Ankan0503/Aether/docs/aether-hierarchy.png

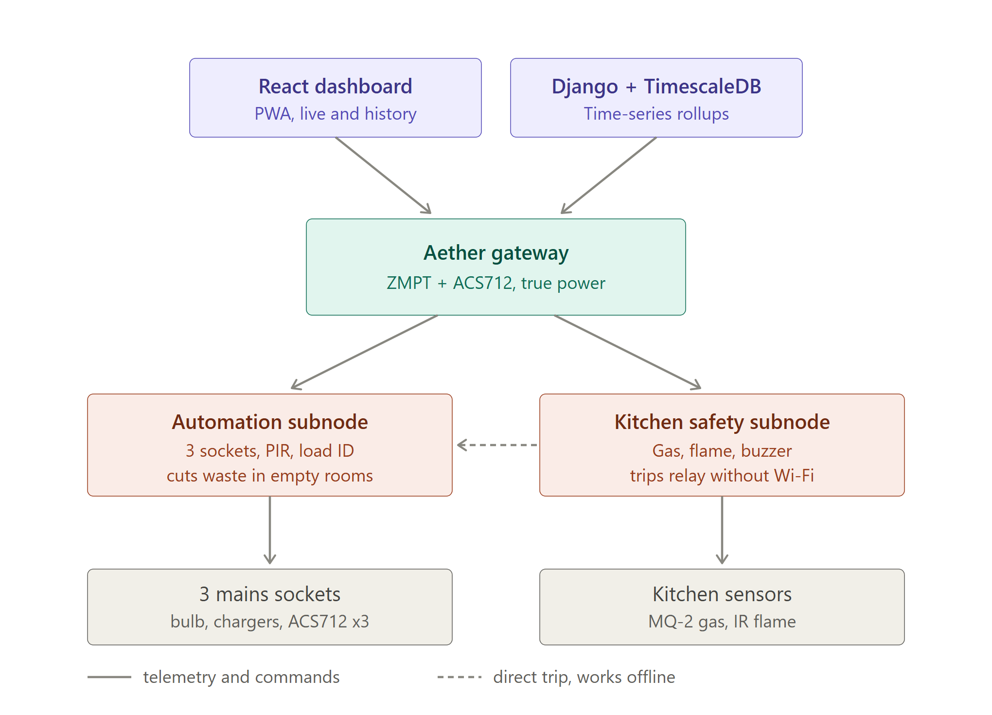
docs/aether-hierarchy.png
