Ankan0503/Aether/docs/waveforms/01-filament-bulb-100w.png

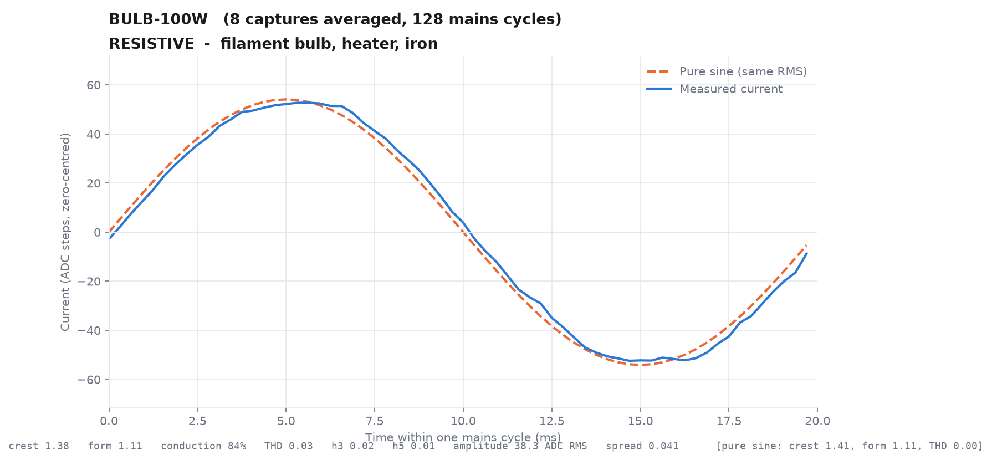
docs/waveforms/01-filament-bulb-100w.png
