Ankan0503/Aether/docs/waveforms/02-laptop-charger-barrel-no-pfc.png

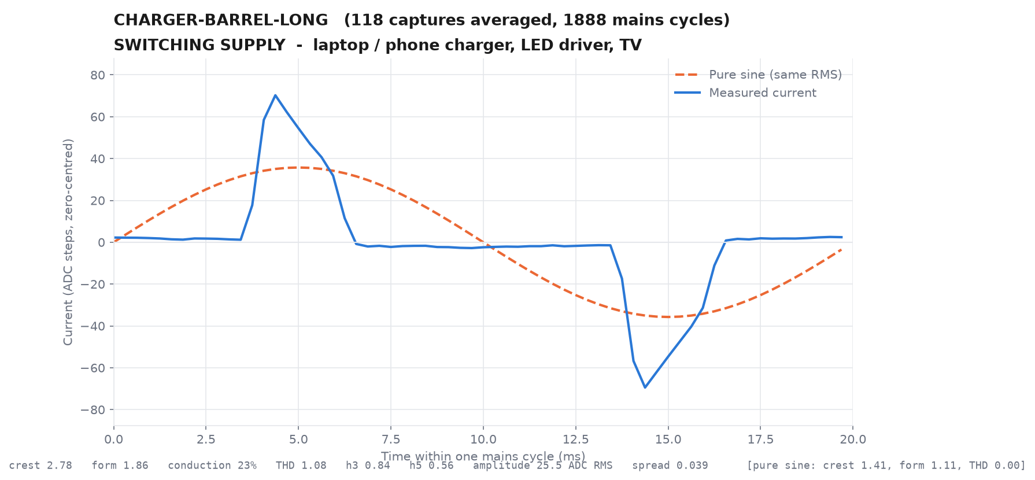
docs/waveforms/02-laptop-charger-barrel-no-pfc.png
