Ankan0503/Aether/docs/waveforms/03-usbc-charger-100w-partial-pfc.png

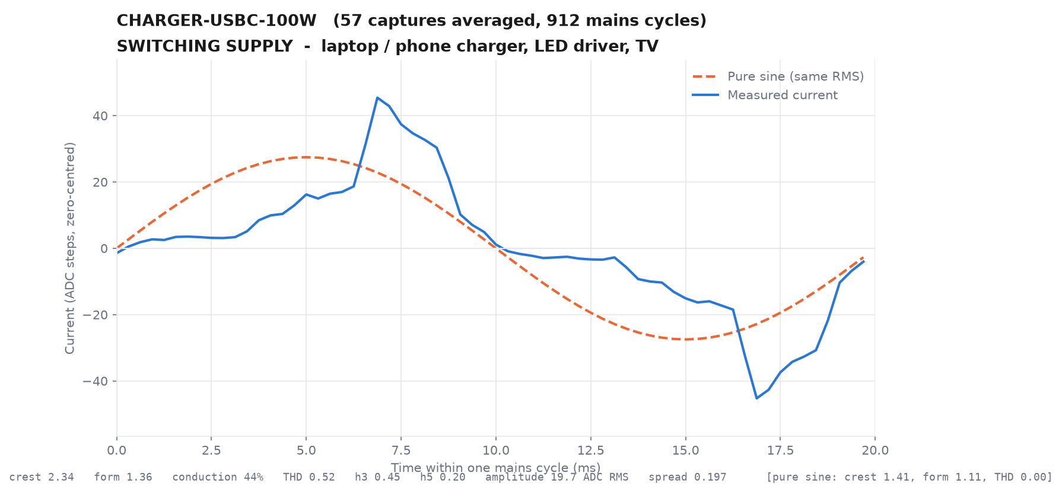
docs/waveforms/03-usbc-charger-100w-partial-pfc.png
