Ankan0503/Aether/docs/waveforms/04-all-three-compared.png

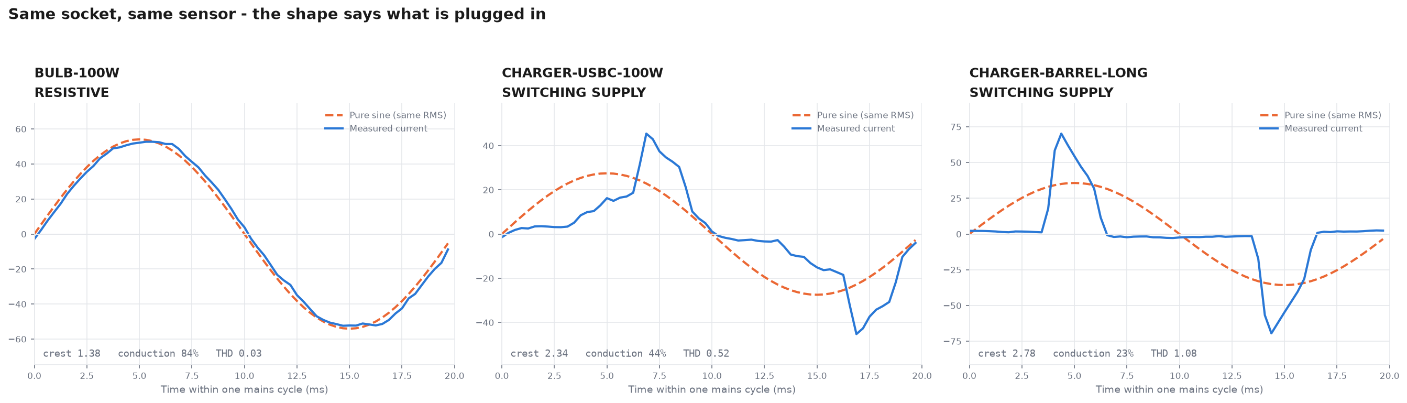
docs/waveforms/04-all-three-compared.png
