Ankan0503/Aether/docs/waveforms/05-noise-floor-empty-socket.png

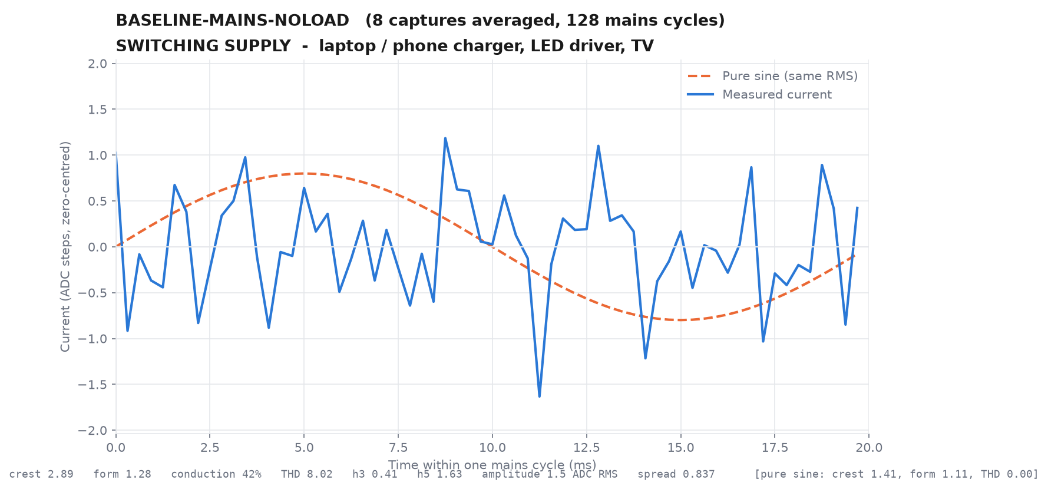
docs/waveforms/05-noise-floor-empty-socket.png
