Ankan0503/Aether/docs/waveforms/06-simulated-reference.png

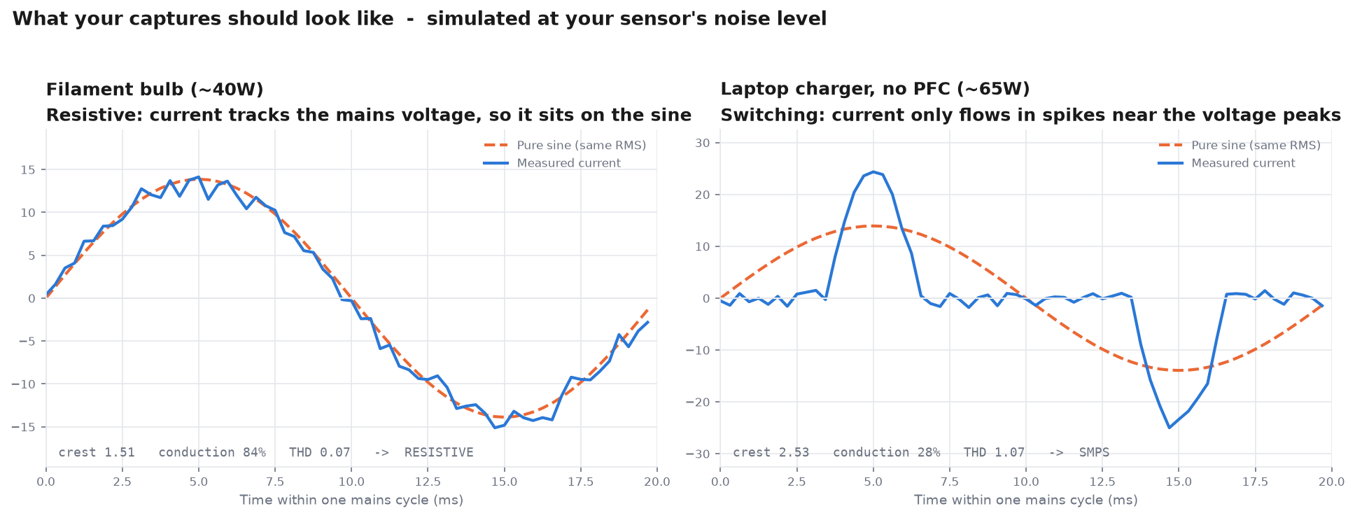
docs/waveforms/06-simulated-reference.png
