Ankan0503/Aether/(commit log)

2026-09-25 Add ESP32 waveform capture and load signature extraction
    Capture one mains cycle of current and reduce it to shape features that do not
    depend on amplitude: crest factor, form factor, conduction angle, THD and the
    odd harmonics.
    Sampling is paced with micros() rather than delayMicroseconds() so the time
    analogRead() itself takes cannot stretch the interval - an uneven sample rate
    smears the harmonics.
    Sixteen consecutive cycles are coherently averaged, anchored to a rising zero
    crossing. Mains-synchronous signal adds linearly while noise adds as sqrt(N),
    which is what makes a small load legible on a 30A ACS712 that resolves only
    about 2.8W per ADC step.
    [Waveform.h]
2026-09-25 Add standalone bench sketch with relay control
    Drives the 4-channel relay board and the ACS712 inputs directly over serial,
    with no Wi-Fi or mesh, so the measurement chain can be proven before any of the
    networking exists. Stores one device profile in NVS so it survives a reboot.
    Relay pins are driven HIGH before pinMode() sets them as outputs. An ESP32 GPIO
    is an input on reset, so an active-LOW relay board would otherwise see a
    floating line and click ON during boot - a real switch-on of a mains socket on
    every reset.
    [Waveform.h, WaveformBench.ino]
2026-09-25 Add shape-based load classifier
    Decode the firmware's base64 cycle, extract shape features and label the load
    as resistive, switching supply or mixed.
    Every feature is computed after normalising by the waveform's own RMS, so the
    classifier is unaffected by ACS712 zero-offset drift, a mis-set sensitivity
    constant or a fixed-voltage power assumption. Shape survives what magnitude
    does not.
    The rule is deliberately small and explainable, and doubles as the fallback and
    the sanity check behind any trained model.
    [load_signature.py]
2026-09-25 Add hardware-free validation of the feature maths
    Synthesise a filament bulb and a non-PFC supply at this sensor's noise level
    and assert the features land where theory says they should.
    The single-cycle case is asserted to FAIL classification while the 16-cycle
    average passes. That contrast is the justification for the coherent averaging,
    so if it ever starts passing the noise model has gone soft.
    [preview_graph.py, selftest.py]
2026-09-25 Add serial capture and relay verification tools
    capture_once.py collects several captures, aligns them by cross-correlation
    and averages. Alignment matters because the zero-crossing anchor is crisp for a
    sine but ambiguous for a supply that sits at zero most of the cycle - averaging
    misaligned captures flattens the spikes and under-reads crest factor badly.
    It reports amplitude spread and shape spread separately, so a loose plug
    (amplitude moves, shape does not) is not mistaken for an unstable reading. The
    relay is opened in a finally block so a finished, failed or interrupted capture
    never leaves a mains socket live.
    relay_test.py confirms a channel physically opens, using the current sen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
    [capture_once.py, relay_test.py]
2026-09-25 Add live oscilloscope and multi-device comparison plots
    Both draw the measured current against a pure sine of the same RMS. Equal area
    under the curve means any visible difference is shape alone, which is exactly
    what the classifier decides on - so the plot shows the reasoning rather than
    just the result.
2026-09-25 Add training pipeline for the load classifier
    Collect labelled waveforms over serial, then fit a shallow decision tree on the
    shape features.
    Shallow on purpose: the learned rules can be printed and read aloud, and with
    features this separable the extra capacity would buy accuracy that cannot be
    demonstrated. Training also prints the hand-written rule's accuracy beside the
    model's, so a model that does not earn its place is visible immediately.
2026-09-25 Add appliance identification with measured reference waveforms
    Match a live capture against known devices by point-by-point shape distance
    after normalisation and phase alignment, rather than by thresholds - the two
    chargers are far closer to each other than either is to the bulb, and a
    threshold that splits resistive from switching cannot separate them.
    Reference captures measured on the rig: a 100W bulb at crest 1.38 against the
    theoretical 1.414, a non-PFC barrel charger at 2.78 with conduction collapsing
    from 84% to 23%, and a partially-corrected 100W USB-C brick between them at
    2.34.
    [captures.csv]
2026-09-25 Add three.js digital twin view
    Interactive 3D model of the home, showing per-room load and the state of each
    switched socket in place rather than as a list.
2026-09-25 Add safety, control, automation and event views
    Hazard hub, the full-screen safety alert overlay with its audio alarm, manual
    relay control, automation rules, settings and the event history feed.
2026-09-25 Add container and nginx deployment config for the frontend
    Multi-stage build serving the built assets through nginx, with the API origin
    templated at runtime.
2026-09-25 Document the load signature approach and measured results
    Covers why shape beats magnitude on this hardware, the measured reference
    values, the wiring and the blind test in which appliances swapped between
    sockets were each identified correctly.
2026-09-25 Document the pin map for all three node types
    Gateway, automation subnode and kitchen safety node, with the ESP32 rules each
    map obeys - ADC1 only for analog since ADC2 dies once Wi-Fi is up, the
    input-only pins, the strapping pins, and driving an active-LOW relay high
    before pinMode so it does not click on at boot.
    Records why socket 3 runs through the relay board's channel 4, and the ZMPT
    trim-pot procedure: set too high it clips flat and corrupts both RMS voltage
    and power factor while still producing plausible numbers.
2026-09-25 Add gateway metering with true power and power factor
    The gateway is the only node measuring voltage and current on the same circuit
    at the same moment, so it is the only place active power can be computed rather
    than guessed.
    Vrms x Irms is apparent power. mean(v*i) is active power, which is what the
    meter bills. Their ratio is the power factor, and on a reactive load the two
    differ by a factor of two - so every rupee figure in the project should come
    from here rather than from a subnode assuming a voltage.
    The DC bias is measured per window instead of assumed to be half rail. Both
    modules centre their output through a trim pot and a divider, neither lands
    exactly at Vcc/2, and both drift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
    [AetherGateway.ino, Metering.h]
2026-09-25 Add metering validation against analytically known loads
    Checks the gateway arithmetic with no hardware: a resistive load must give
    power factor 1.0, a load lagging 60 degrees must give exactly 0.5, a distorted
    but in-phase supply must fall below 1 from harmonics alone, and an off-centre
    bias must change nothing.
    It caught a real fault. MT_PHASE_SHIFT interpolates between the previous and
    current voltage sample, so 1.0 means no correction - but it was set to 0.30,
    which is most of a sample of lag. At 32 samples per cycle that is 11.25
    degrees, and cos(60 - 11.25) = 0.659 matched the wrong output exactly. On
    hardware it would have quietly overstated power on every reactive load.
    [metering_selftest.py]
2026-09-25 Add subnode occupancy cutoff and per-socket load identification
    Three sockets, each identified by current waveform shape, opened automatically
    when something is drawing and the room has been empty.
    The rule is built around what the sensor can actually see. A 30A ACS712 has a
    measured noise floor near 1.5 ADC RMS steps and true standby draw is about 0.5,
    so standby is invisible and a rule waiting to detect it would never fire. What
    is visible is a load still drawing with nobody present - a lamp left on, a
    charger still pulling - and that is real waste worth cutting.
    Savings are reported in ADC-step-seconds rather than watts on purpose: the
    subnode has no voltage reference, and converting wo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
    [AetherSubNode.ino, Occupancy.h, Waveform.h]
2026-09-25 Add system hierarchy diagram
    Four tiers from dashboard down to sensors, showing the gateway as the only
    point measuring voltage and current together, and the direct ESP-NOW link
    between the kitchen and automation subnodes that keeps gas and fire cutoff
    working with Wi-Fi down.
2026-09-25 Add device registry, pairing and layout
    Device discovery, MQTT pairing commands, appliance toggling and the room and
    door models the occupancy logic will need.
    Fixes a missing 'from django.db.models import Q' import that made every device
    deletion fail with a 500 and leave the device, its telemetry and its load
    signatures behind - it was used in five places and imported in none.
2026-09-25 Add telemetry ingestion and the MQTT listener
    Subscribes to aether/#, parses node payloads and records readings.
    Two fixes on top of the imported code. The node's declared role is now honoured
    instead of being inferred from whether c1-c4 appear in the payload: the gateway
    carries no per-socket currents, so it was being registered as a plain sensor -
    the one device that can actually measure power factor, mislabelled.
    And a socket prediction failure no longer aborts the ingest. It reads back
    recent history, so it raises whenever there is none, and the exception was
    taking the whole payload down with it.
2026-09-25 Store telemetry on change rather than on every sample
    The gateway publishes every 2 seconds and a relay node writes one row per
    socket plus a combined one - about 172,800 rows a day, near 50 MB, which
    exhausts a small managed database in a fortnight. Almost every one of those
    rows repeats the previous value.
    Deadband plus heartbeat: keep a sample when something changed, or when it has
    been 60 seconds since the last one. A steady load drops from 43,200 rows a day
    per stream to 1,440 while every transition is still recorded at full fidelity.
    Safety is exempt. A change in status or flame, or a gas reading crossing its
    threshold, is always stored immediately - a deduplication rule must never b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
2026-09-25 Separate live state from stored history
    The latest-telemetry endpoint read the database on every poll, so the
    dashboard's liveness depended on the storage policy - turn writes off and the
    screen goes blank. These are different concerns and should not share a
    mechanism.
    Live readings are now held per device in memory and served first, which also
    makes TELEMETRY_PERSIST=False useful: telemetry still arrives, still drives
    predictions and still reaches the frontend, it just leaves no trace.
    The view now orders by timestamp rather than id. A live reading may be unsaved,
    so its id is None and max() on it would raise - and on a hypertable, timestamp
    is the partitioning column, so the planner goes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
2026-09-25 Make TelemetryReading a TimescaleDB hypertable
    Chunked by day, with an hourly per-socket continuous aggregate, compression
    after 7 days and 90-day retention. No model or query changes - same table, same
    ORM.
    Two things blocked it. TimescaleDB requires every unique index on a hypertable
    to include the partitioning column, so the primary key is rebuilt as
    (timestamp, id); Django still treats id as the key. And a hypertable cannot be
    the target of a foreign key, so ApplianceStatePrediction's reference carries
    db_constraint=False.
    The aggregate uses time_weight() rather than avg(). Because samples are stored
    irregularly by the deadband policy, a plain average is biased toward whichever
    state p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
2026-09-25 Identify what is plugged into each socket from its waveform
    Routes action="WF" frames to the shape classifier and stores the verdict with
    the 64-point waveform behind it, so the dashboard can draw the trace rather
    than only print a label.
    The server recomputes every feature from the waveform instead of trusting the
    node's own verdict. Stale firmware thresholds cannot skew the history, and
    improving the classifier needs no reflash.
2026-09-25 Add tests for the storage policy, pause switch and waveform ingest
    29 tests. They pin the edges that matter: safety is never suppressed, sensor
    noise is never mistaken for a change, sockets are judged independently, and a
    node claiming RESISTIVE while sending a charger's waveform is still stored as
    SMPS.
    They run on SQLite. Tiger Cloud refuses to create the throwaway database
    Django's test runner wants, and migrations are disabled for tests because 0007
    uses PostgreSQL-only casts - the migrations are verified by applying cleanly
    against the real service instead.
2026-09-25 Add anomaly, hazard, recommendation and notification apps
    The ML services and their trained artefacts, hazard scoring, the savings
    engine and web push, brought over from Aether.
    Emoji were stripped from every print statement in this backend. On a cp1252
    Windows console they raise UnicodeEncodeError, and in the MQTT listener that
    runs on a background thread - the crash was silent, and the listener died after
    connecting but before subscribing.
2026-09-25 Add gateway networking: Wi-Fi provisioning, ESP-NOW and MQTT
    The gateway is the only node on both networks, bridging MQTT over TLS to the
    backend and ESP-NOW to the subnodes. Protocol matches the existing Aether
    gateway exactly, so the backend and any already-flashed node work unchanged.
    The heartbeat carries the gateway's Wi-Fi channel because ESP-NOW peers must
    share one, and a router can move it at any time. Without that broadcast the
    mesh goes silently deaf after a channel change - nodes still powered, still
    paired, nothing getting through.
    It now also announces itself on aether/discovery when MQTT connects. Before, it
    only appeared once its first telemetry arrived and never before pai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
2026-09-25 Give the subnode both roles behind one compile switch
    DEVICE_TYPE_AUTOMATION for the socket node, DEVICE_TYPE_KITCHEN for gas and
    flame, with #error guards so selecting both or neither fails at compile time.
    The kitchen role broadcasts TRIP_RELAY straight to the relay node over ESP-NOW,
    with no gateway, Wi-Fi or internet in the path, and repeats it every 3 seconds
    while the hazard lasts - a single broadcast can be dropped, and an undelivered
    trip is the one failure this node exists to prevent. Fire and gas use different
    tones so they can be told apart from another room.
    Unpaired nodes sweep channels while broadcasting DISCOVER. Without the sweep a
    node only ever finds a gateway that happen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
    [AetherSubNode.ino, Mesh.h]
2026-09-25 Document the pin map for all three node types
    Gateway, automation subnode and kitchen node, with the ESP32 rules each map
    obeys and why socket 3 runs through the relay board's channel 4.
2026-09-25 Replace the Digital Twin with the ESP Room Architect
    The old view rendered a fixed three.js model - a house nobody could edit. This
    one lets you lay out your own home in 2D or 2.5D, which is what makes per-room
    occupancy and the door graph mean anything; the backend's layout app already
    has Room and doors waiting for it.
    Ported from VoltOrchestra. Its two callbacks are reimplemented as shims over
    Aether's addToast rather than rewriting twenty call sites in 2,500 lines of
    working layout code, and the neutral chrome is retuned to the Aether palette
    while room swatches are left alone.
    Removed the invented mesh panel: hardcoded 192.168.1.x addresses, made-up RSSI
    figures and a claim about WebS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
2026-09-25 Add the measured waveforms and the system diagram
    Six traces captured on the real rig, with the noise floor included as a
    control - without seeing what formless noise looks like there is no reason to
    believe the others are not just pretty curves.
    Plus a four-tier hierarchy diagram showing the gateway as the only point
    measuring voltage and current together, and the direct ESP-NOW link that keeps
    gas and fire cutoff working with Wi-Fi down.
